MHassanNadeem/line-follower-robot/DLC - Line Follower Robot.jpg

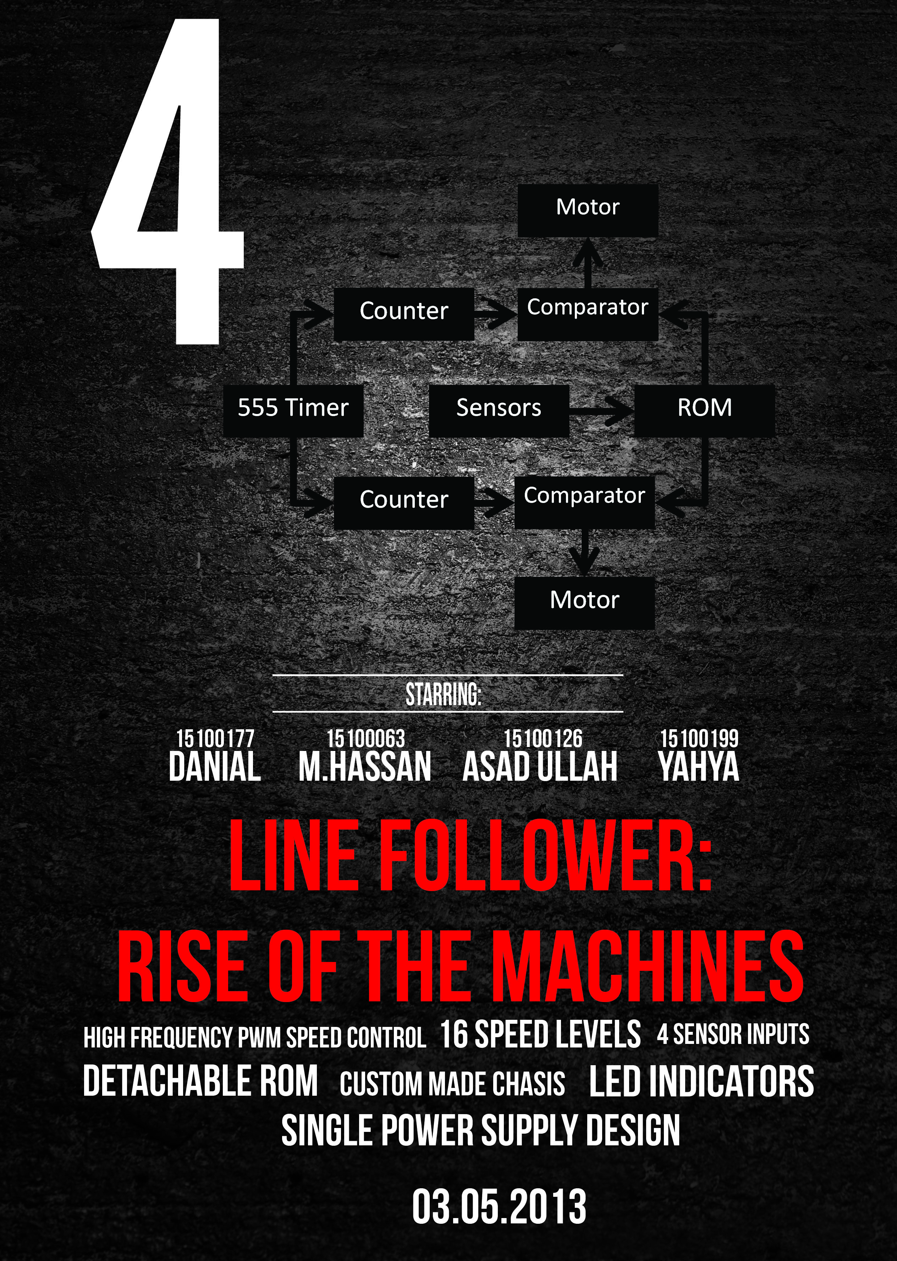
DLC - Line Follower Robot.jpg
