MHassanNadeem/line-follower-robot/(list of files, drawings)

Other design files:
Fixed Sensors/Sensors.DSN
Fixed Sensors/Sensors.LYT
Lights.DSN
Lights.LYT
Sensors.DSN
Sensors.LYT
THIS-9 jumpers.LYT
THIS.DSN
